yeugautruc/StandardTorqueMachine-HUSTVietnam/Newhandbar/Assemhand.SLDASM

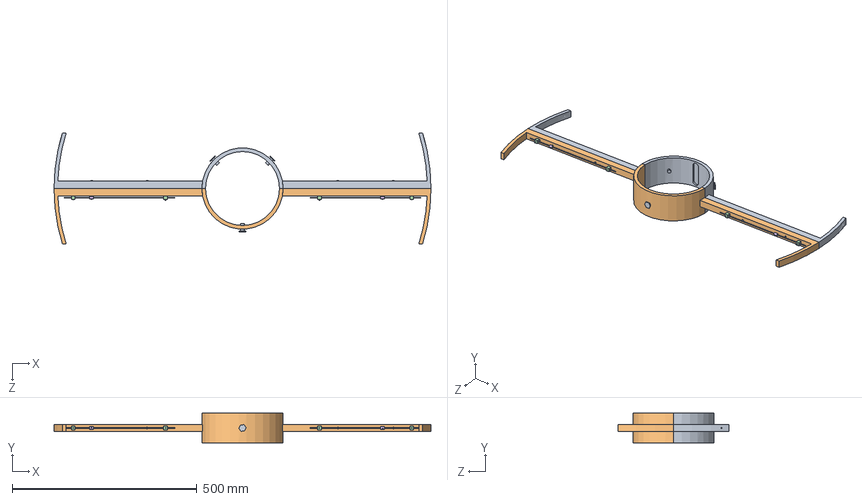
[picture p1: CAD file, 2020-05-11]
Newhandbar/Assemhand.SLDASM
1020.0 x 80.0 x 300.0 mm
partabove
partbelow
screws x 4
atta x 4
bar x 2
balance mass x 2
screws-mass2 x 2
screws-mass x 4
SCREWW x 3
