yeugautruc/StandardTorqueMachine-HUSTVietnam/Straight mearsure/ASSEM.SLDASM

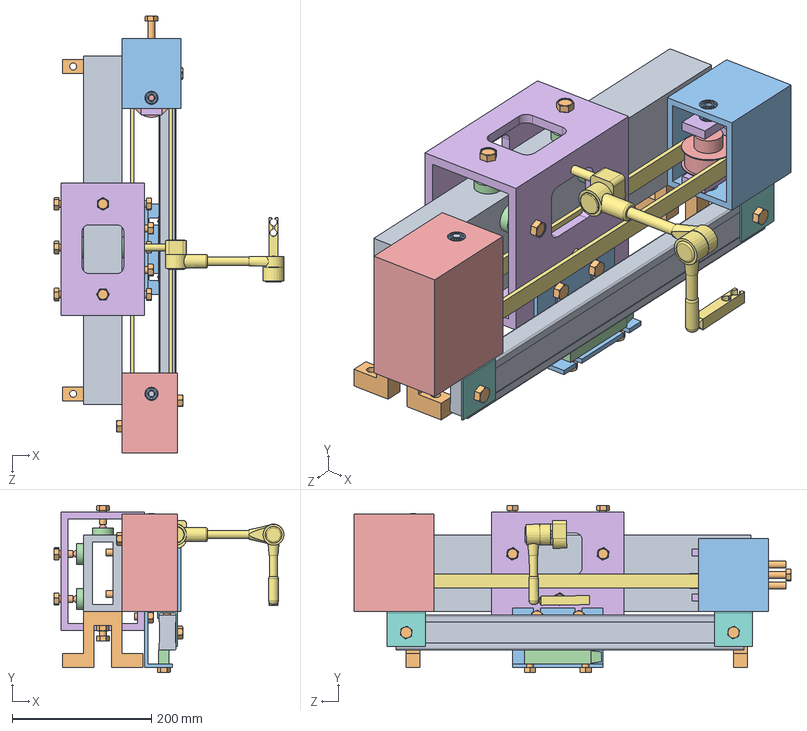
[picture p2: CAD file, 2020-05-11]
Straight mearsure/ASSEM.SLDASM
330.2 x 240.0 x 627.5 mm
Shaft
base x 2
attach bearing
bearing40 x 10
Ball x 10
Guildway
clamping tool
attach linear scale x 2
linear scale
hex screw_am x 26
attach moving part LS
moving part ofLC
right mecha bearing
attach right mecha bearing
belt
motor
left mecha bearing
attach motor part
radial ball bearing_68_am x 6
motor belt
new left box attach motor
