yeugautruc/StandardTorqueMachine-HUSTVietnam/ST momen/ASSEM.SLDASM

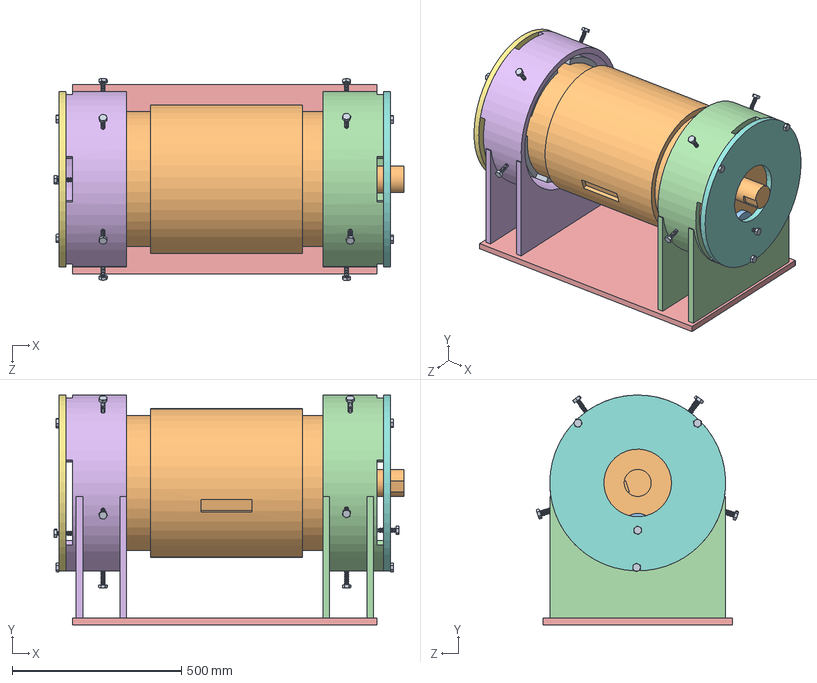
[picture p3: CAD file, 2020-05-11]
ST momen/ASSEM.SLDASM
1035.0 x 679.9 x 598.6 mm
Left bearing
right bearing
Ball x 12
Ring attach bearing left
Base
Ring attach bearing right
Close side left
Close side right
heavy hex bolt_ai x 18
Spindle
Sidebearing x 2
