yeugautruc/StandardTorqueMachine-HUSTVietnam/Newhandbar/partabove.SLDPRT

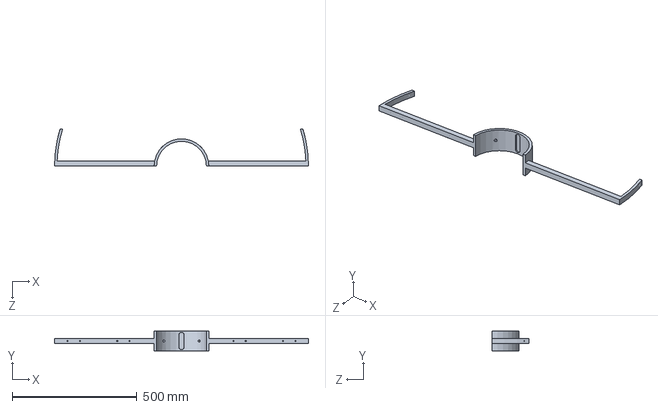
[picture p4: CAD file, 2020-05-11]
Newhandbar/partabove.SLDPRT
1020.0 x 80.0 x 150.0 mm
