yeugautruc/StandardTorqueMachine-HUSTVietnam/ST momen/Left bearing2.SLDPRT

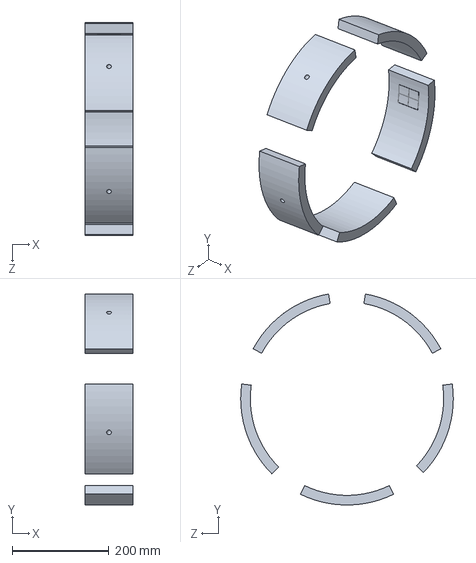
[picture p5: CAD file, 2020-05-11]
ST momen/Left bearing2.SLDPRT
100.0 x 436.7 x 440.0 mm
