yeugautruc/StandardTorqueMachine-HUSTVietnam/Straight mearsure/Shaft.SLDPRT

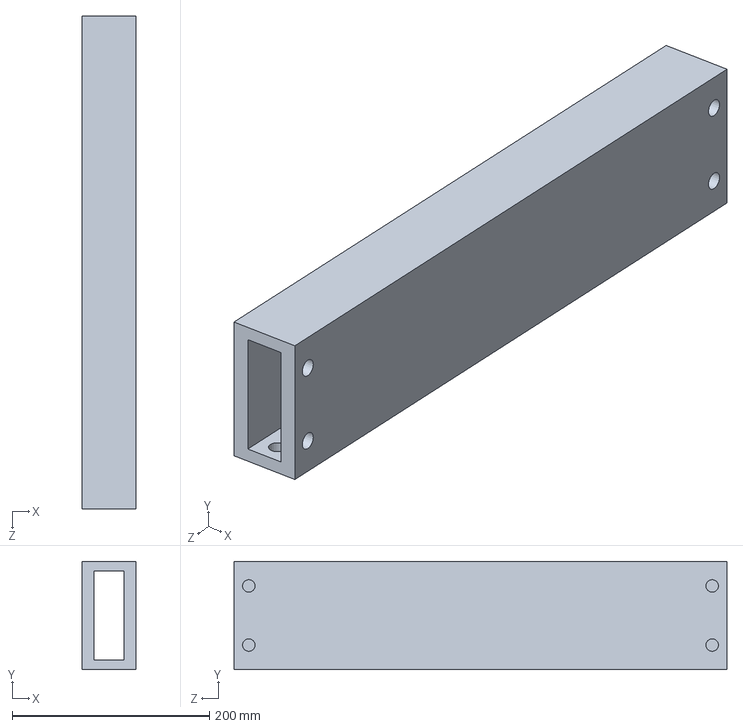
[picture p6: CAD file, 2020-05-11]
Straight mearsure/Shaft.SLDPRT
55.0 x 110.0 x 500.0 mm
