yeugautruc/StandardTorqueMachine-HUSTVietnam/ST momen/Base.SLDPRT

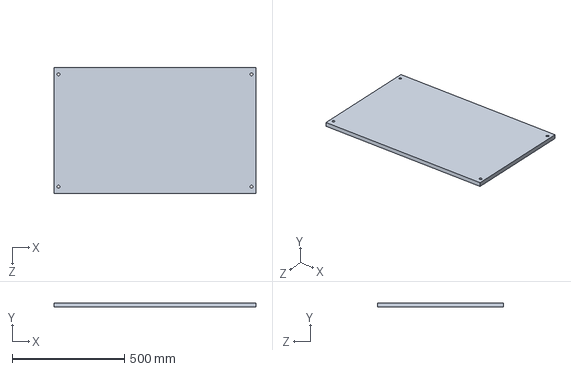
[picture p7: CAD file, 2020-05-11]
ST momen/Base.SLDPRT
900.0 x 20.0 x 560.0 mm
