yeugautruc/StandardTorqueMachine-HUSTVietnam/Straight mearsure/right mecha bearing.SLDPRT

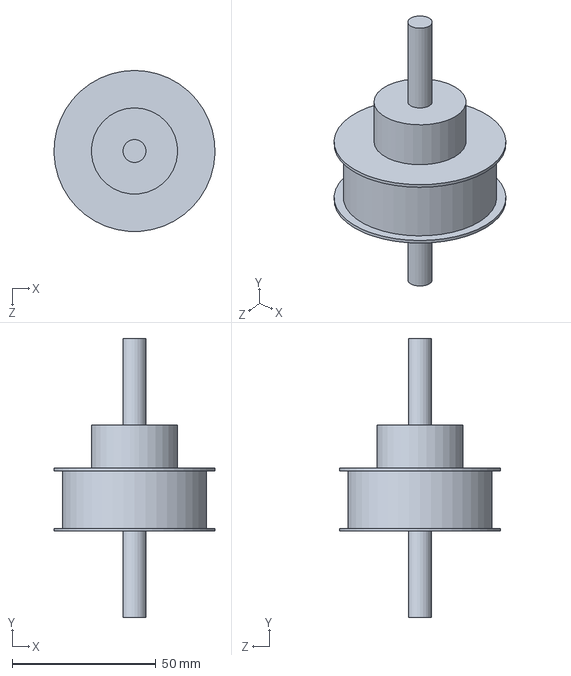
[picture p8: CAD file, 2020-05-11]
Straight mearsure/right mecha bearing.SLDPRT
56.0 x 97.0 x 56.0 mm
