yeugautruc/StandardTorqueMachine-HUSTVietnam/ST momen/Close side right.SLDPRT

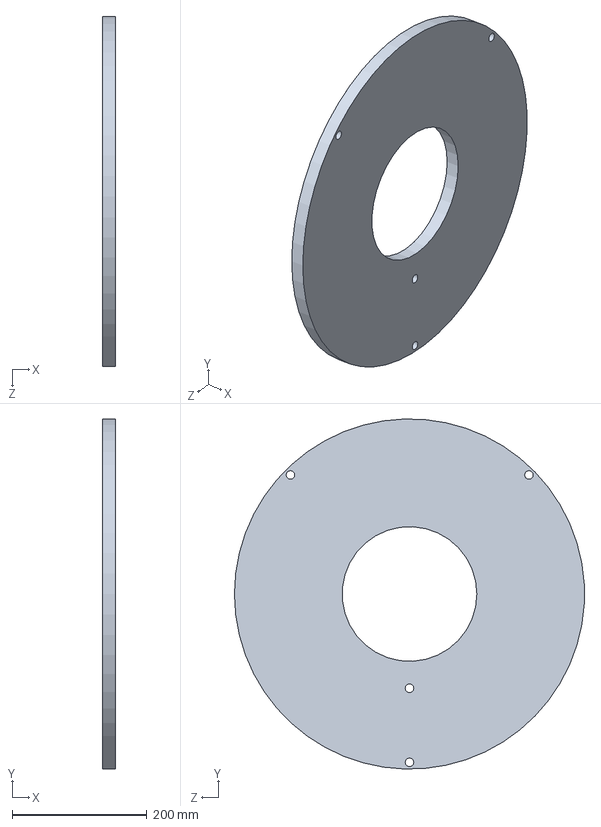
[picture p9: CAD file, 2020-05-11]
ST momen/Close side right.SLDPRT
20.0 x 519.8 x 520.0 mm
