yeugautruc/StandardTorqueMachine-HUSTVietnam/Straight mearsure/attach motor.SLDPRT

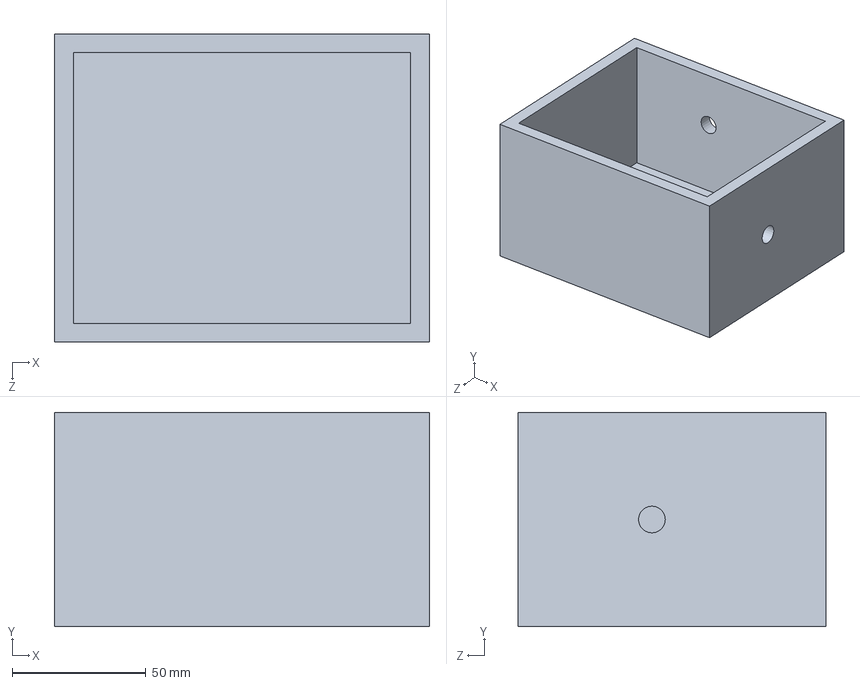
[picture p10: CAD file, 2020-05-11]
Straight mearsure/attach motor.SLDPRT
140.0 x 80.0 x 115.0 mm
