yeugautruc/StandardTorqueMachine-HUSTVietnam/Newhandbar/bar.SLDPRT

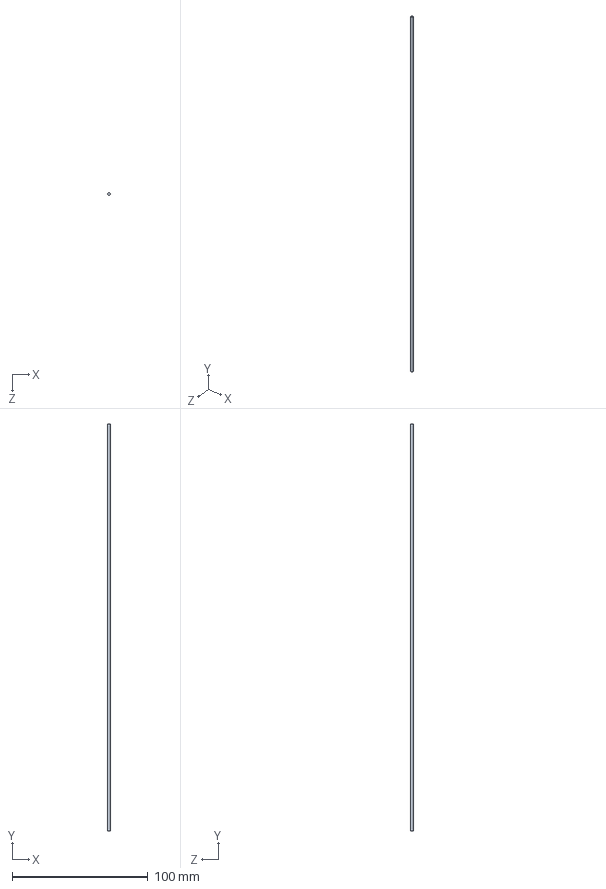
[picture p11: CAD file, 2020-05-11]
Newhandbar/bar.SLDPRT
2.00 x 300.0 x 2.00 mm
