yeugautruc/StandardTorqueMachine-HUSTVietnam/Straight mearsure/motor belt.SLDPRT

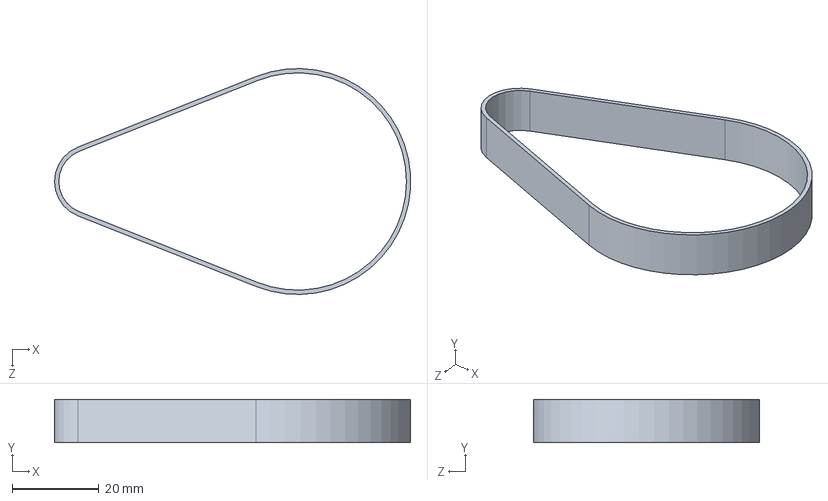
[picture p12: CAD file, 2020-05-11]
Straight mearsure/motor belt.SLDPRT
81.9 x 10.0 x 52.0 mm
