yeugautruc/StandardTorqueMachine-HUSTVietnam/ST momen/Spindle.SLDPRT

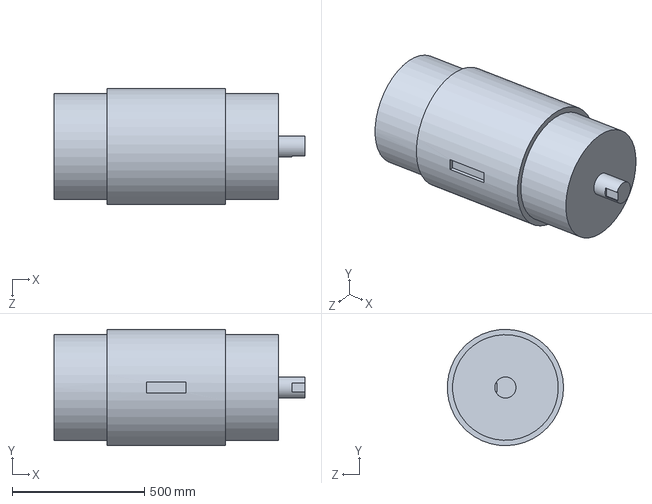
[picture p13: CAD file, 2020-05-11]
ST momen/Spindle.SLDPRT
950.0 x 439.7 x 439.4 mm
