yeugautruc/StandardTorqueMachine-HUSTVietnam/Straight mearsure/Guildway.SLDPRT

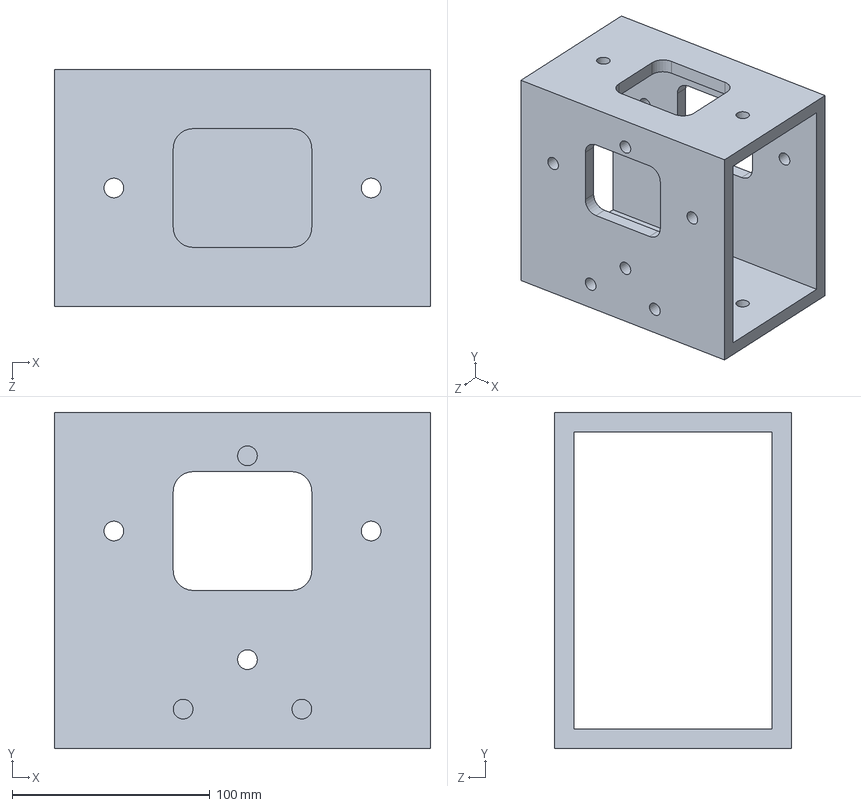
[picture p14: CAD file, 2020-05-11]
Straight mearsure/Guildway.SLDPRT
190.0 x 170.0 x 120.0 mm
