yeugautruc/StandardTorqueMachine-HUSTVietnam/ST momen/Ring attach bearing left.SLDPRT

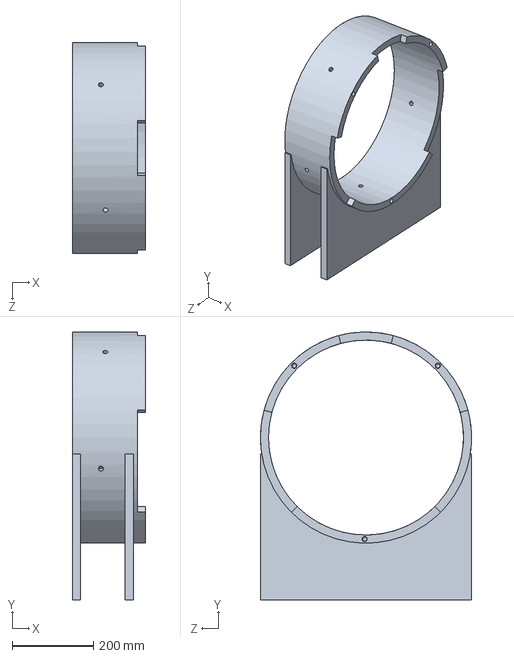
[picture p15: CAD file, 2020-05-11]
ST momen/Ring attach bearing left.SLDPRT
180.0 x 659.9 x 520.0 mm
