yeugautruc/StandardTorqueMachine-HUSTVietnam/Straight mearsure/bearing40.SLDPRT

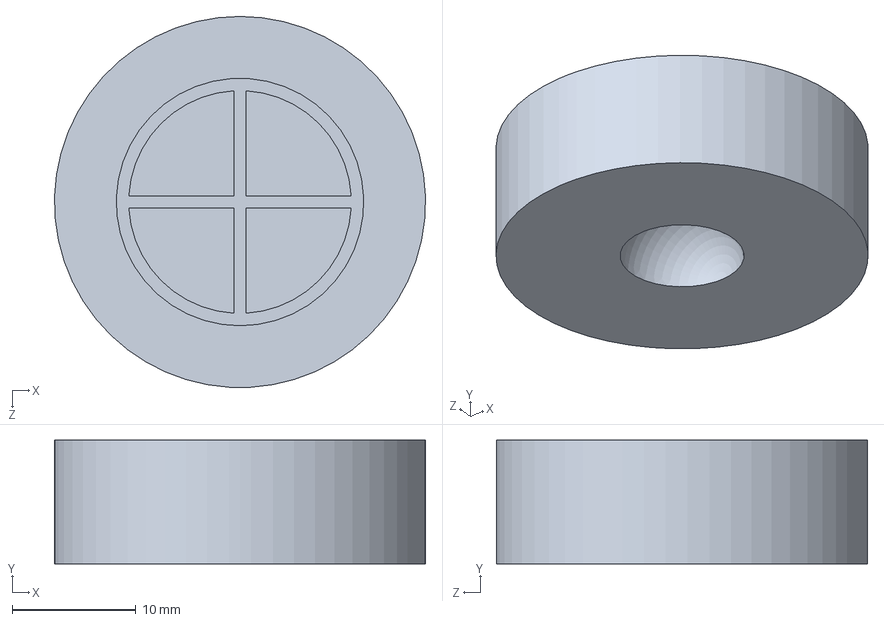
[picture p16: CAD file, 2020-05-11]
Straight mearsure/bearing40.SLDPRT
30.0 x 10.0 x 30.0 mm
