yeugautruc/StandardTorqueMachine-HUSTVietnam/Newhandbar/balance mass.SLDPRT

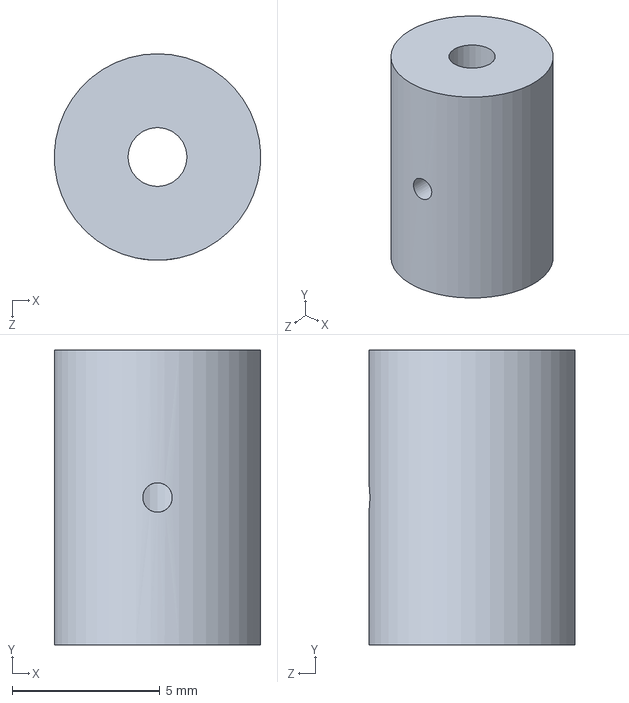
[picture p17: CAD file, 2020-05-11]
Newhandbar/balance mass.SLDPRT
7.00 x 10.0 x 7.00 mm
