yeugautruc/StandardTorqueMachine-HUSTVietnam/ST momen/airflow.SLDPRT

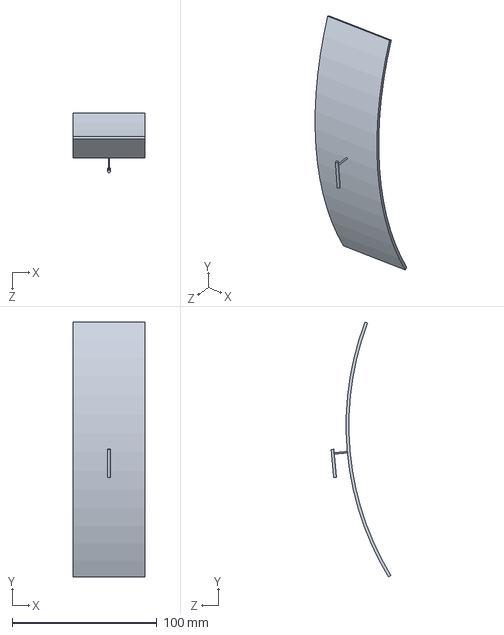
[picture p18: CAD file, 2020-05-11]
ST momen/airflow.SLDPRT
50.0 x 176.4 x 41.4 mm
