yeugautruc/StandardTorqueMachine-HUSTVietnam/Straight mearsure/Ball.SLDPRT

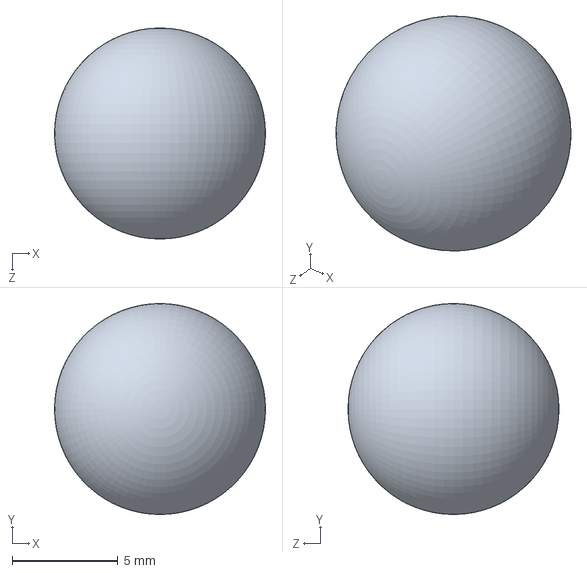
[picture p19: CAD file, 2020-05-11]
Straight mearsure/Ball.SLDPRT
10.0 x 10.0 x 10.0 mm
