yeugautruc/StandardTorqueMachine-HUSTVietnam/Straight mearsure/attach linear scale.SLDPRT

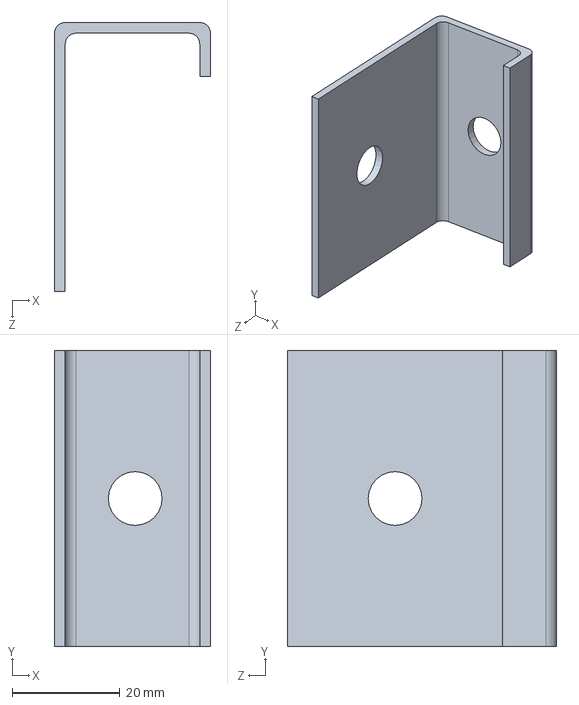
[picture p20: CAD file, 2020-05-11]
Straight mearsure/attach linear scale.SLDPRT
29.0 x 55.0 x 50.0 mm
