yeugautruc/StandardTorqueMachine-HUSTVietnam/Newhandbar/atta.SLDPRT

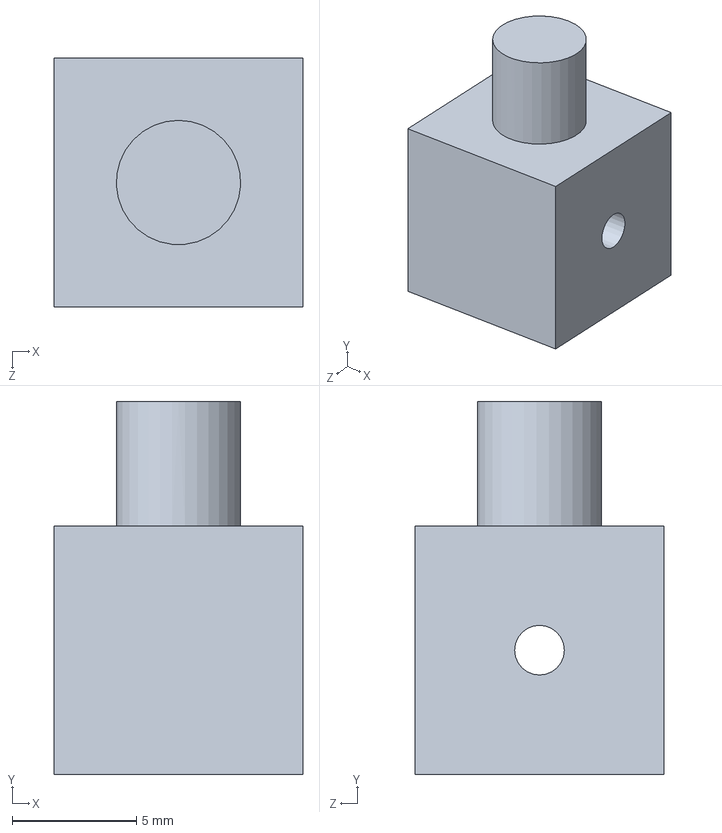
[picture p21: CAD file, 2020-05-11]
Newhandbar/atta.SLDPRT
10.0 x 15.0 x 10.0 mm
