yeugautruc/StandardTorqueMachine-HUSTVietnam/ST momen/Close side left.SLDPRT

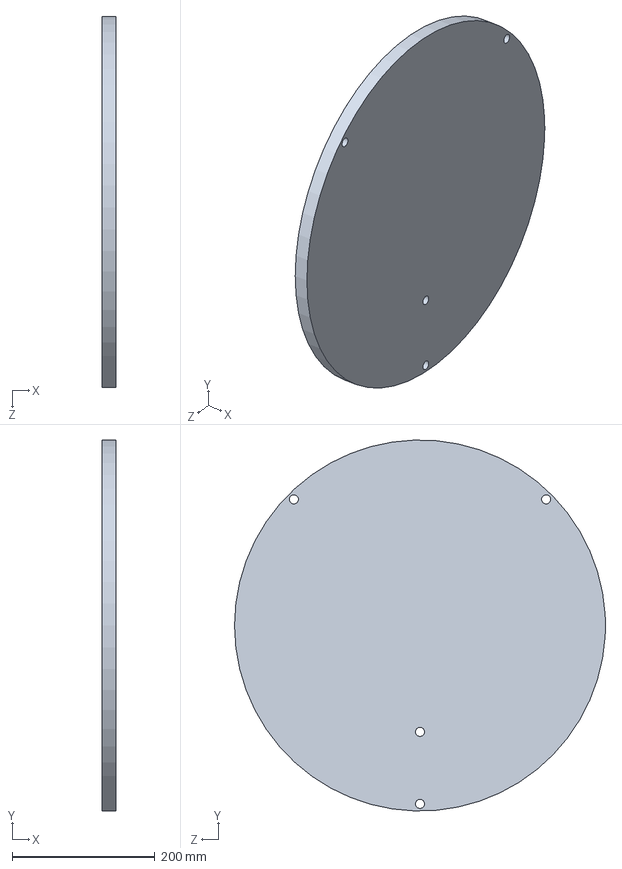
[picture p22: CAD file, 2020-05-11]
ST momen/Close side left.SLDPRT
20.0 x 519.8 x 520.0 mm
