yeugautruc/StandardTorqueMachine-HUSTVietnam/Straight mearsure/base.SLDPRT

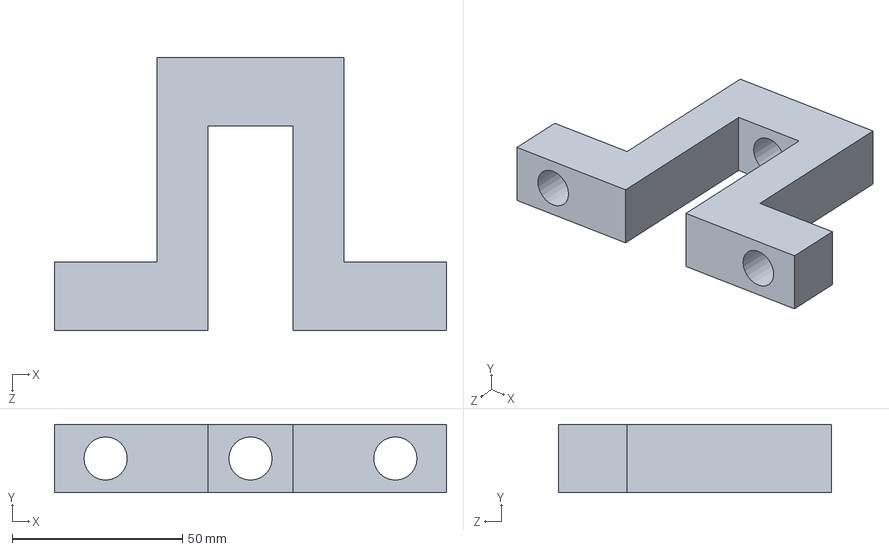
[picture p23: CAD file, 2020-05-11]
Straight mearsure/base.SLDPRT
115.0 x 20.0 x 80.0 mm
