yeugautruc/StandardTorqueMachine-HUSTVietnam/ST momen/Sidebearing.SLDPRT

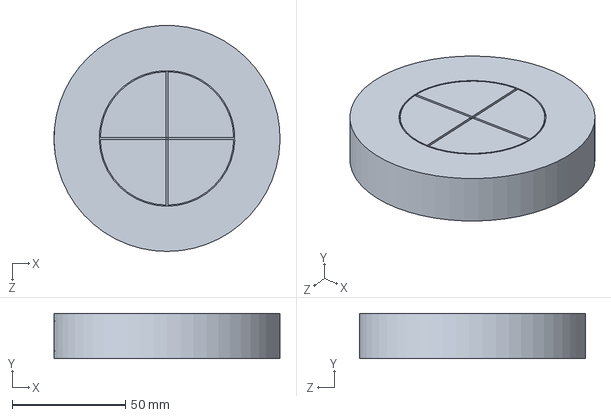
[picture p24: CAD file, 2020-05-11]
ST momen/Sidebearing.SLDPRT
100.0 x 20.0 x 99.9 mm
