yeugautruc/StandardTorqueMachine-HUSTVietnam/Straight mearsure/attach right mecha bearing.SLDPRT

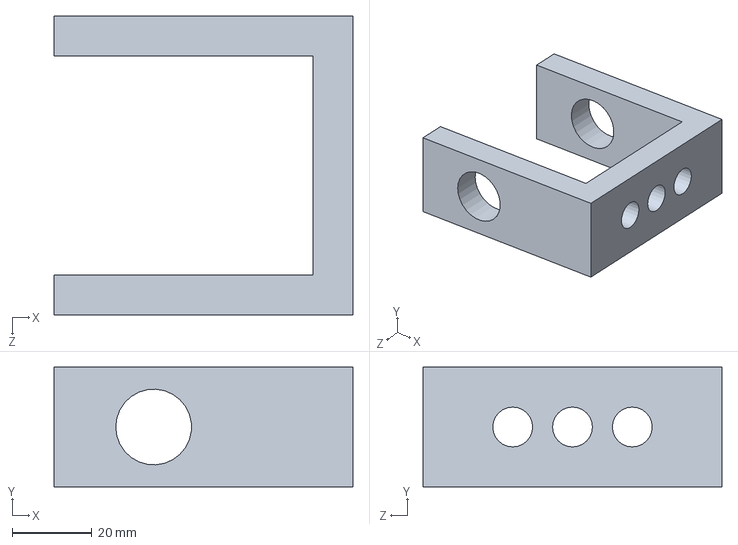
[picture p25: CAD file, 2020-05-11]
Straight mearsure/attach right mecha bearing.SLDPRT
75.0 x 30.0 x 75.0 mm
