yeugautruc/StandardTorqueMachine-HUSTVietnam/Straight mearsure/attach bearing.SLDPRT

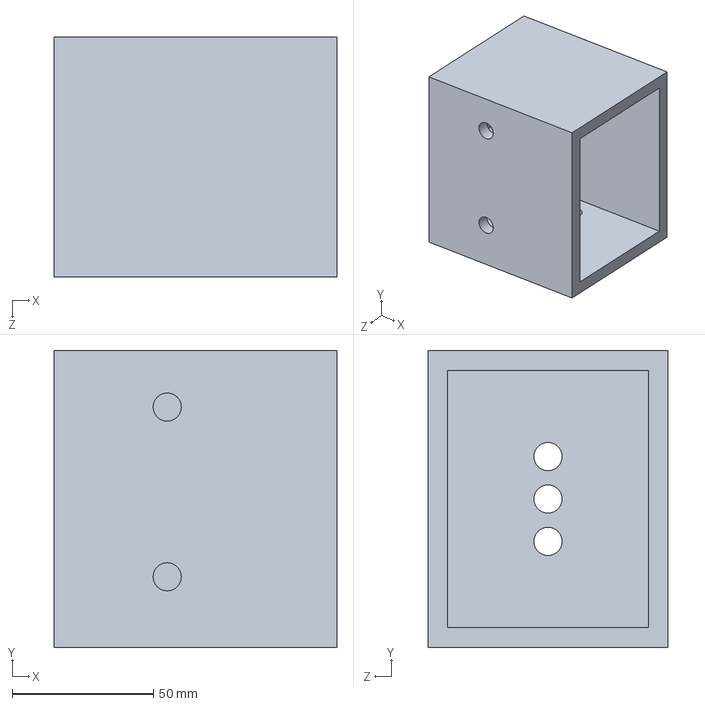
[picture p26: CAD file, 2020-05-11]
Straight mearsure/attach bearing.SLDPRT
100.0 x 105.0 x 85.0 mm
