yeugautruc/StandardTorqueMachine-HUSTVietnam/Straight mearsure/clamping tool.SLDPRT

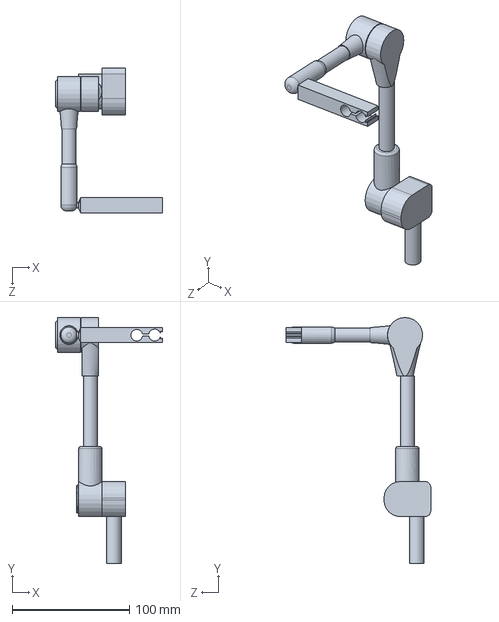
[picture p27: CAD file, 2020-05-11]
Straight mearsure/clamping tool.SLDPRT
91.8 x 210.0 x 123.5 mm
