yeugautruc/StandardTorqueMachine-HUSTVietnam/Straight mearsure/motor.SLDPRT

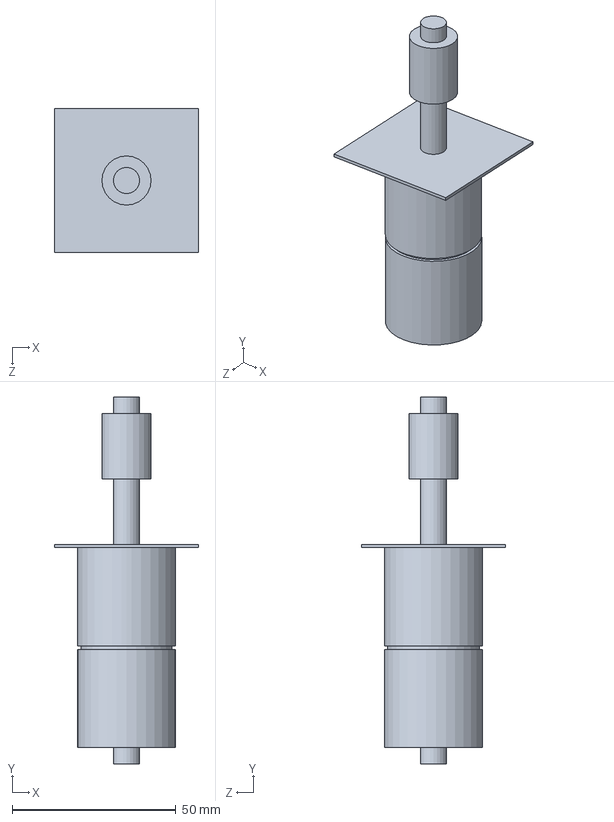
[picture p28: CAD file, 2020-05-11]
Straight mearsure/motor.SLDPRT
44.0 x 112.0 x 44.0 mm
