yeugautruc/StandardTorqueMachine-HUSTVietnam/Straight mearsure/attach motor part.SLDPRT

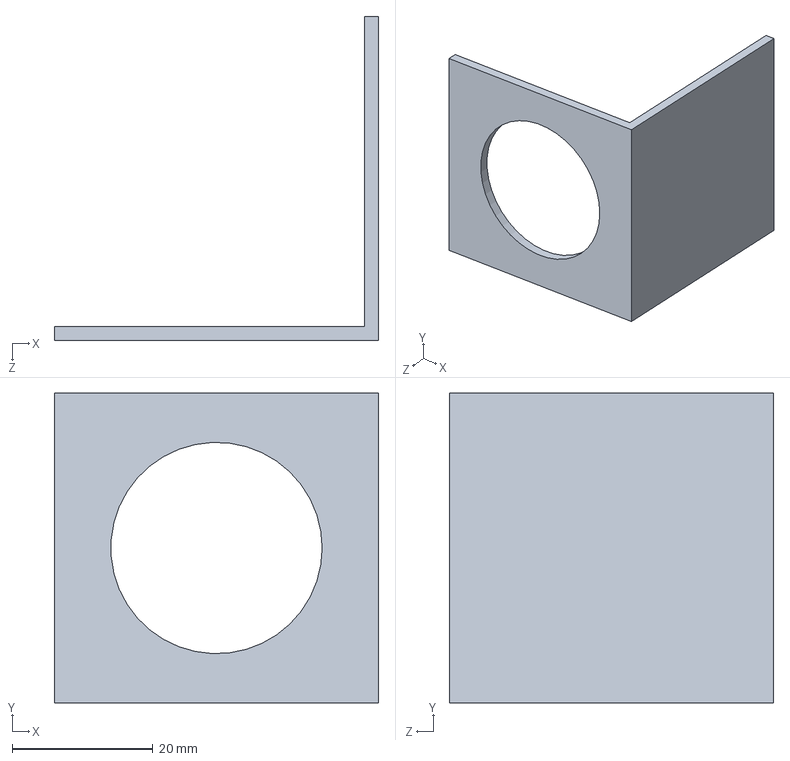
[picture p29: CAD file, 2020-05-11]
Straight mearsure/attach motor part.SLDPRT
46.0 x 44.0 x 46.0 mm
