yeugautruc/StandardTorqueMachine-HUSTVietnam/Straight mearsure/moving part ofLC.SLDPRT

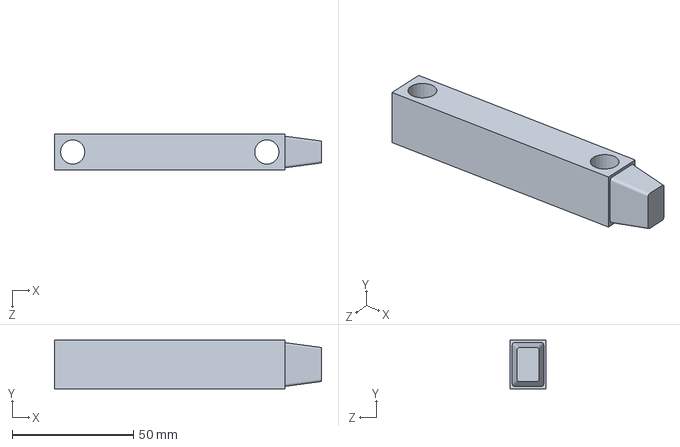
[picture p30: CAD file, 2020-05-11]
Straight mearsure/moving part ofLC.SLDPRT
110.0 x 20.0 x 15.0 mm
