yeugautruc/StandardTorqueMachine-HUSTVietnam/Straight mearsure/new left box attach motor.SLDPRT

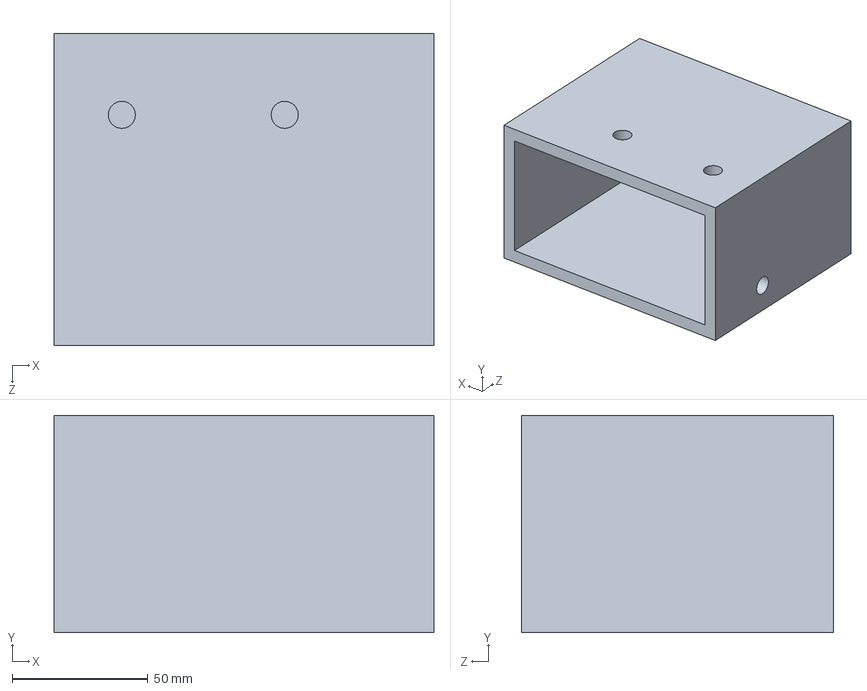
[picture p31: CAD file, 2020-05-11]
Straight mearsure/new left box attach motor.SLDPRT
140.0 x 80.0 x 115.0 mm
