yeugautruc/StandardTorqueMachine-HUSTVietnam/Straight mearsure/belt.SLDPRT

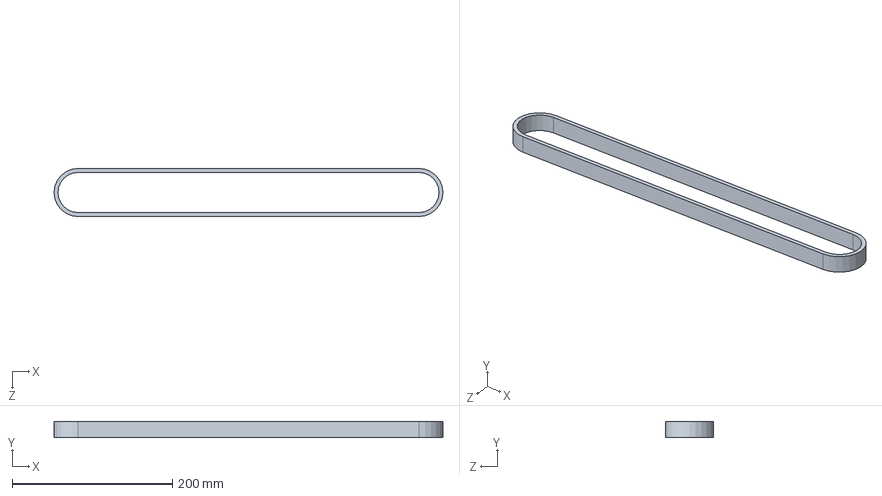
[picture p32: CAD file, 2020-05-11]
Straight mearsure/belt.SLDPRT
485.0 x 20.0 x 60.0 mm
