yeugautruc/StandardTorqueMachine-HUSTVietnam/Straight mearsure/linear scale.SLDPRT

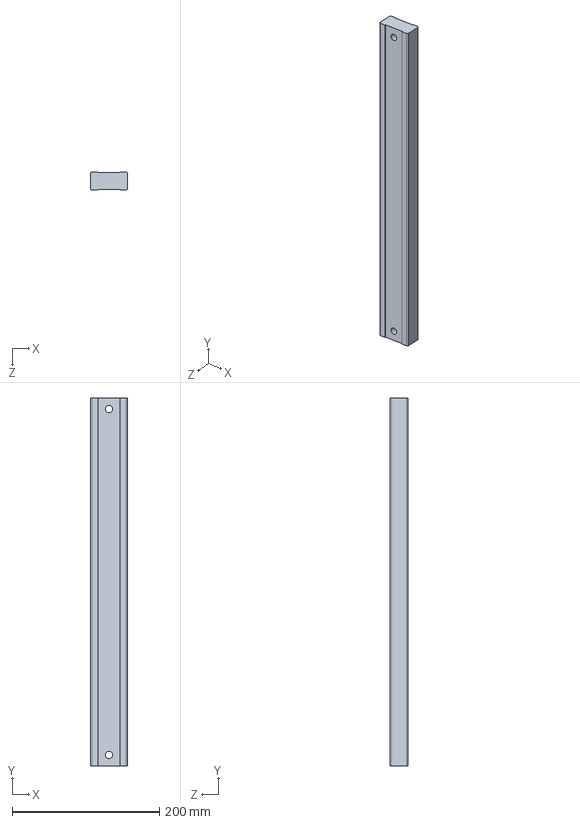
[picture p33: CAD file, 2020-05-11]
Straight mearsure/linear scale.SLDPRT
50.0 x 500.0 x 25.0 mm
