yeugautruc/StandardTorqueMachine-HUSTVietnam/Straight mearsure/attach moving part LS.SLDPRT

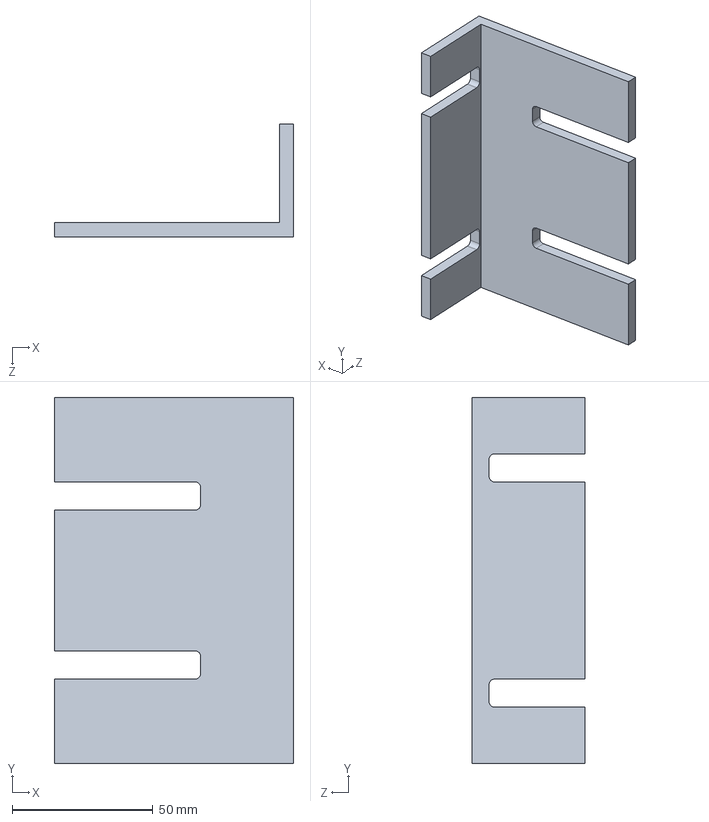
[picture p34: CAD file, 2020-05-11]
Straight mearsure/attach moving part LS.SLDPRT
85.0 x 130.0 x 40.0 mm
