yeugautruc/StandardTorqueMachine-HUSTVietnam/Straight mearsure/left mecha bearing.SLDPRT

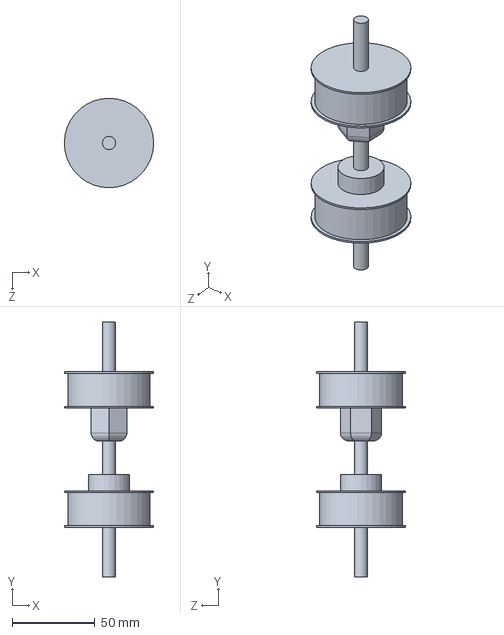
[picture p35: CAD file, 2020-05-11]
Straight mearsure/left mecha bearing.SLDPRT
54.0 x 154.0 x 54.0 mm
