yeugautruc/StandardTorqueMachine-HUSTVietnam/(list of files, cad)

Other CAD files:
Newhandbar/Check/duoi.DWG
Straight mearsure/acad/neww.DWG
Newhandbar/Check/tren.DWG
Straight mearsure/acad/ASSEMf.DWG
Newhandbar/Check/assem.DWG
Straight mearsure/acad/ASSEM.DWG
ST momen/right bearing.SLDPRT
Newhandbar/partbelow.SLDPRT
ST momen/Ring attach bearing right.SLDPRT
ST momen/Left bearing.SLDPRT
Newhandbar/Check/assem.SLDDRW
Newhandbar/Check/duoi.SLDDRW
Newhandbar/Check/tren.SLDDRW
Newhandbar/SCREWW.SLDPRT
Newhandbar/pdf/Assemhand.SLDDRW
Newhandbar/screws-mass.SLDPRT
Newhandbar/screws-mass2.SLDPRT
Newhandbar/screws.SLDPRT
ST momen/Draw1.SLDDRW
Straight mearsure/acad/ASSEM.SLDDRW
