yeugautruc/StandardTorqueMachine-HUSTVietnam/Newhandbar/Check/duoi.PDF

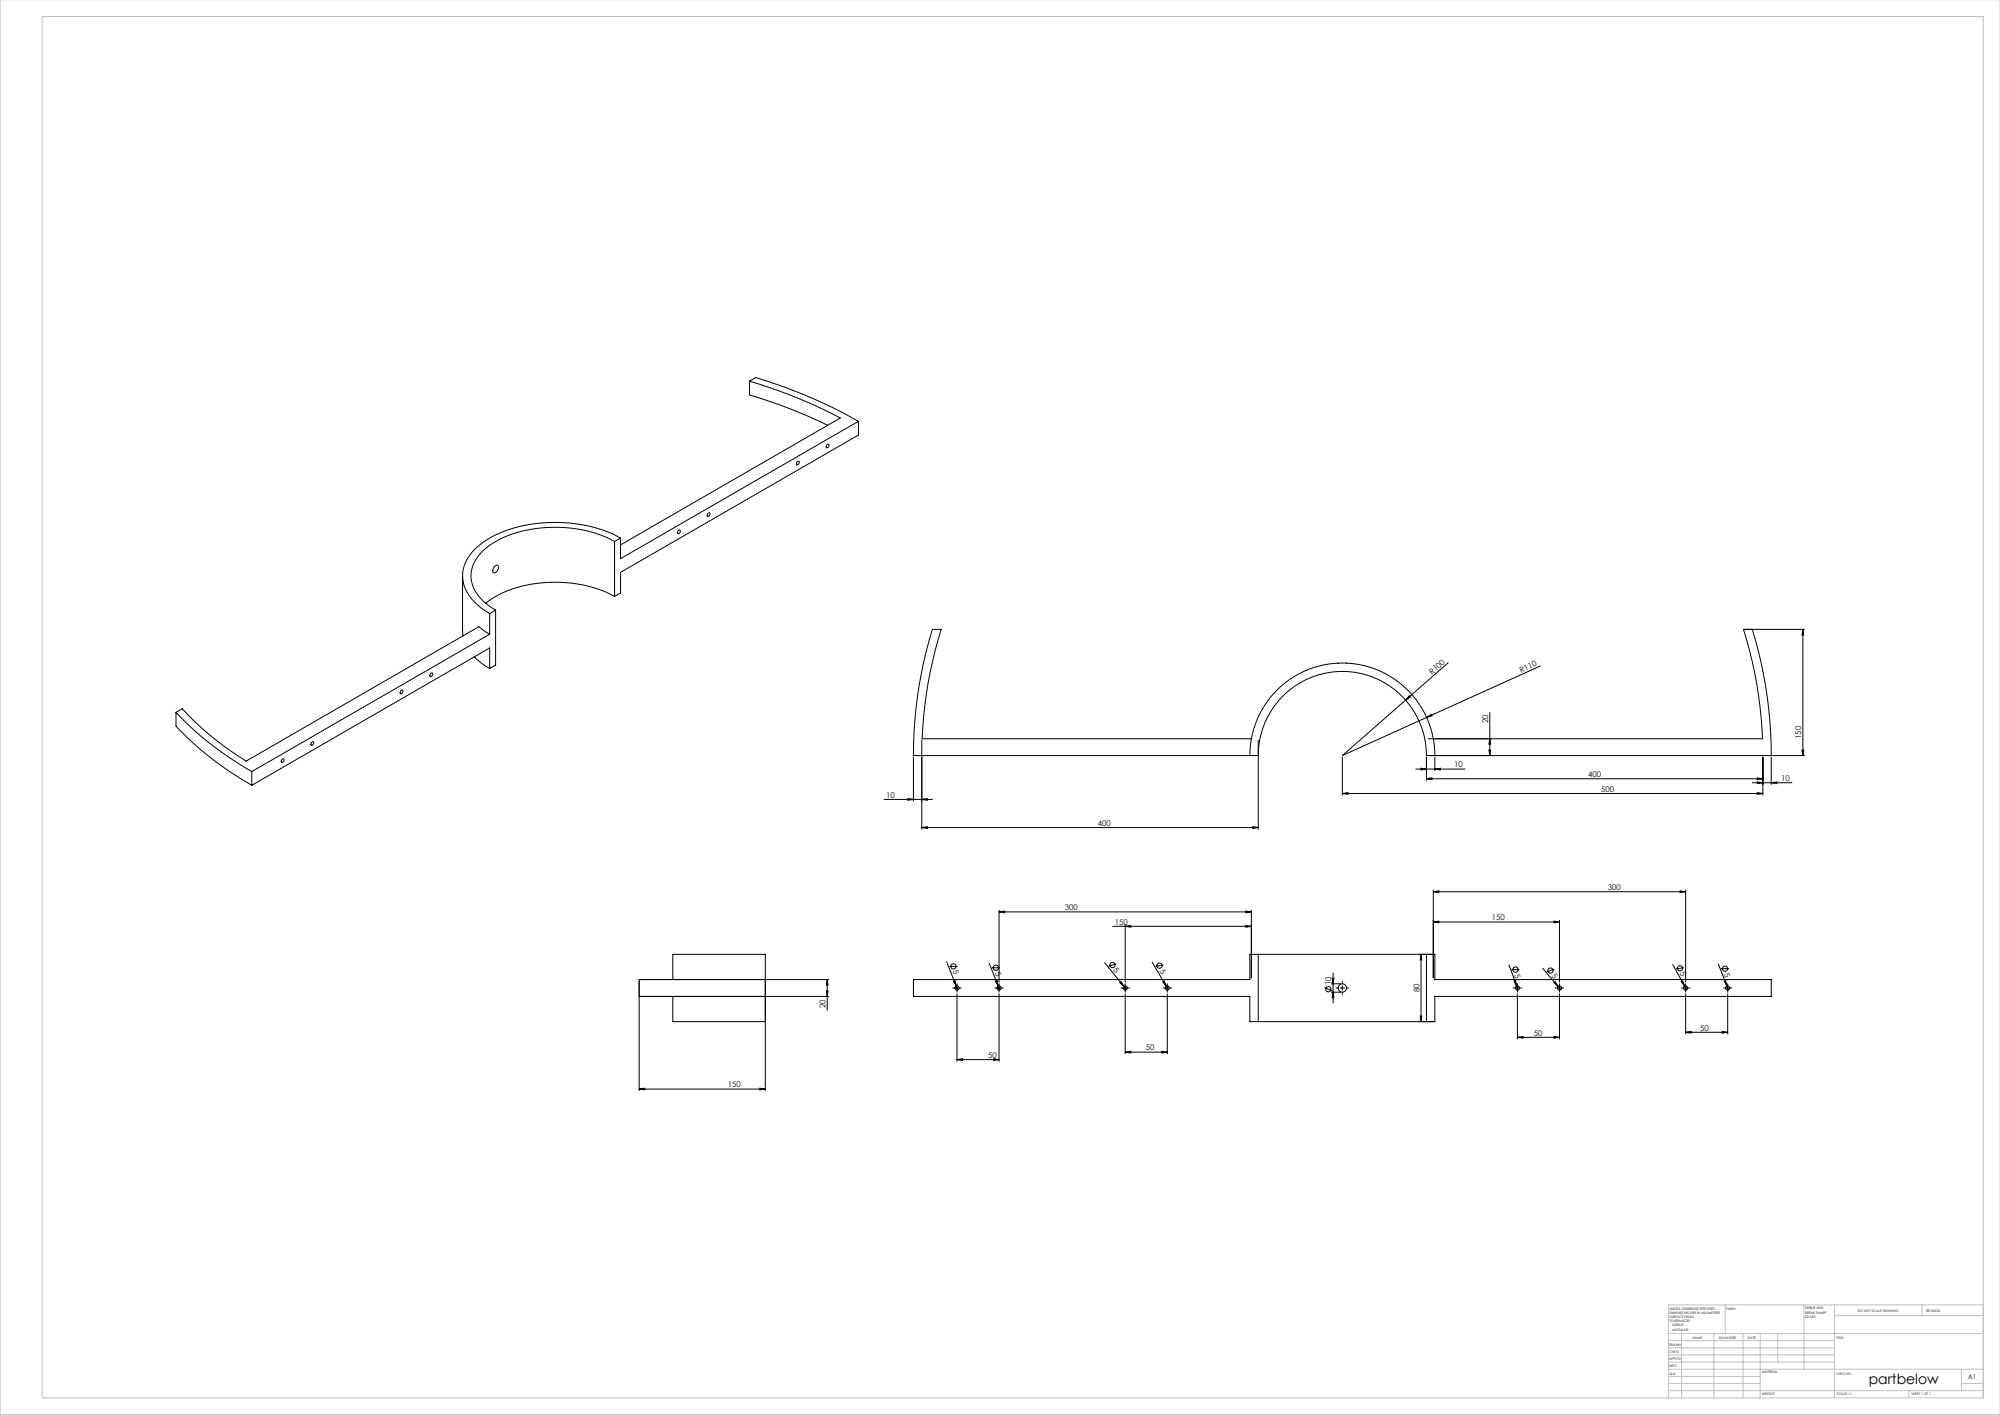
[picture p46: page 1]
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

DIMENSIONS ARE IN MILLIMETERS
SURFACE FINISH:
TOLERANCES:
LINEAR:
ANGULAR:

NAME | SIGNATURE | DATE | | | | TITLE:
Q.A | | | | MATERIAL: | partbelow WEIGHT: DWG NO. | A1

DRAWN
CHK'D
APPV'D
MFG
